ErwinRafaelNovicio/soft-robotic-gripper/(list of files, cad)

Other CAD files:
cad/finger/Finger.ipt
cad/finger/Finger_1.ipt
cad/finger/Finger_2.ipt
cad/finger/Finger_3.ipt
cad/finger/Finger_4.ipt
cad/finger/Moving_Finger.iam
cad/gripper/Base.ipt
cad/gripper/Base_Closure.ipt
cad/gripper/Closure.ipt
cad/gripper/Lateral Support.ipt
cad/gripper/Palm.ipt
cad/gripper/PalmClosure.ipt
cad/gripper/Palm_Support.ipt
cad/gripper/Soft_Gripper.iam
cad/gripper/Staffa.ipt
cad/gripper/Whippletree.ipt
cad/gripper/amewi_6208mg.STEP.iam
