ErwinRafaelNovicio/soft-robotic-gripper/setup/Arduino-motor setup scheme.pdf

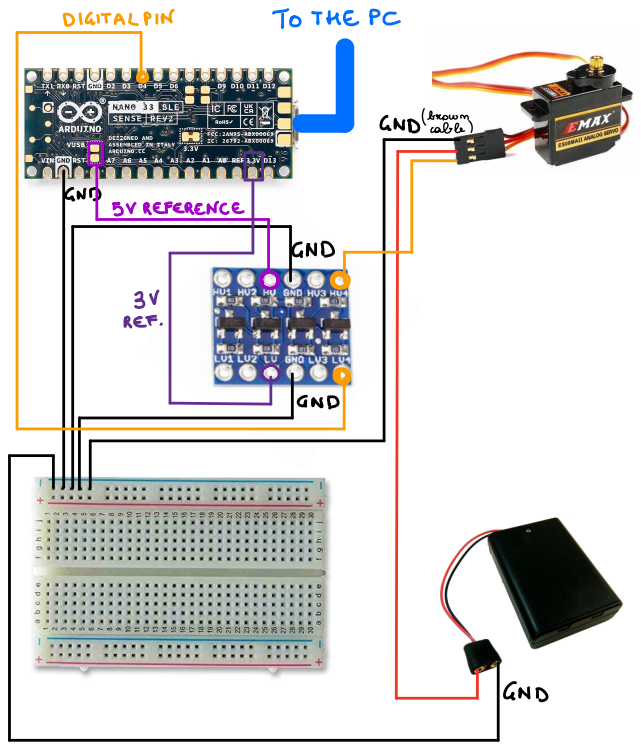
[picture p61: page 1]
DIGITALPIN; TO THE PC; GNDlIaeFI-; GND

GND5VREFERENCE-GND-oa-3V-REF.o
